ManInBlack-coder/three-dimensional-measurement/(commit log)

2026-11-09 first prototype
2026-11-09 fixed core logic and improved file structure
    [scanner.py]
2026-11-09 Make results robust to sensor noise, servo error and wide beam
    The benchmark showed that noise above ~2 cm, a 3 % servo travel error
    or the TF-Luna's 2° beam each threw the volume off by 4-15 %. Each fix
    below was checked with benchmark.py (3 positions, 5 runs per scenario):
    - Smooth ranges with a 3x3 median over neighbouring beams (only where
    the median is within 20 cm, so edges stay put), and let the floor
    plan reach the wall pixel centres.
    Noise 2 cm + 1 %: -15.4 % -> -2.5 %.
    - kalibreeri is now automatic: it sweeps both servos across a flat wall
    and fits r = d / cos(s * (angle - c)) to get the level angle and each
    servo's scale (--pan-skaala, --tilt-skaala). The benchmark cal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
    [lidar_skanner.ino, scanner.py]
